DroneBotWorkshop/db1-robot-base/README.md

# db1-robot-base
 Base and drive section of DB1 Robot project

 Consists of following sub-sections:

 - Arduino Mega
 - Motor Controller
 - Corner Sensor
