DroneBotWorkshop/db1-robot-base/motor-controller/documentation/Motor-Control-2.0-REV-2-Schematic-2020-05-04.pdf

# Left Motor Controller

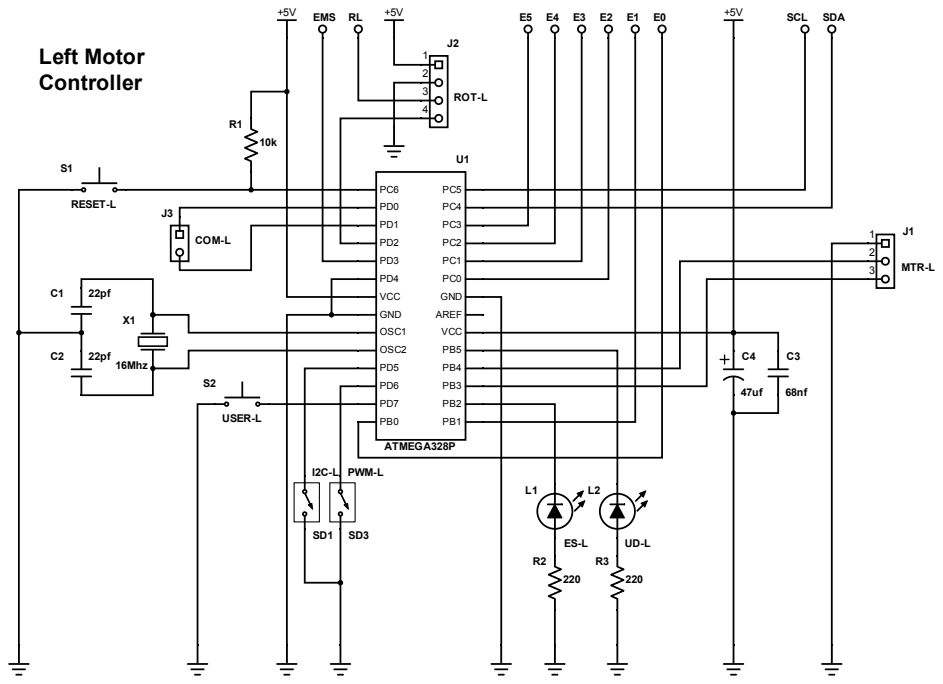
[picture p8: page 1]

# Right Motor Controller

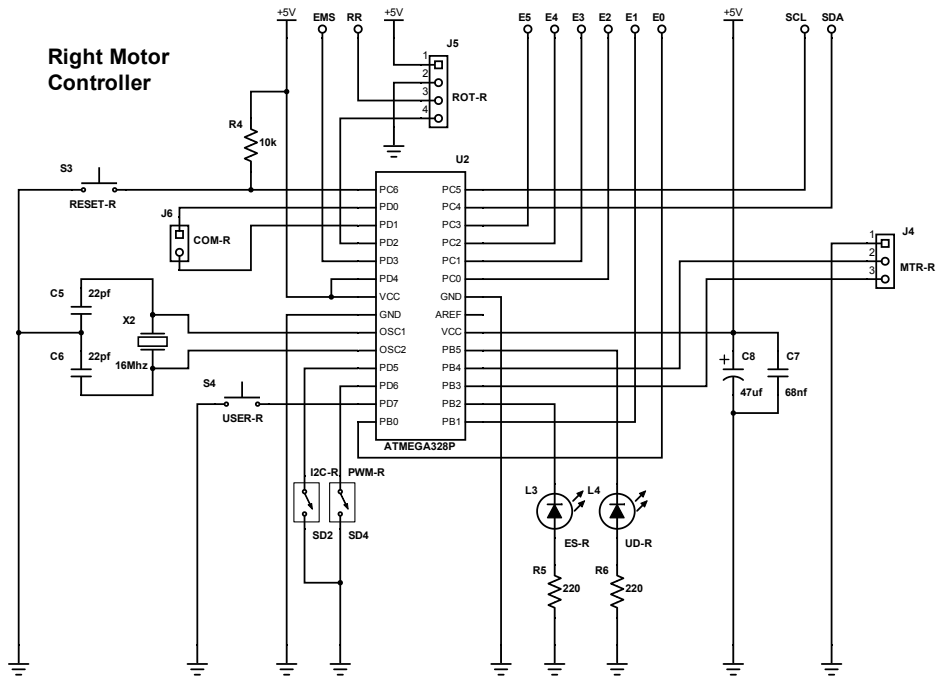
[picture p9: page 2]

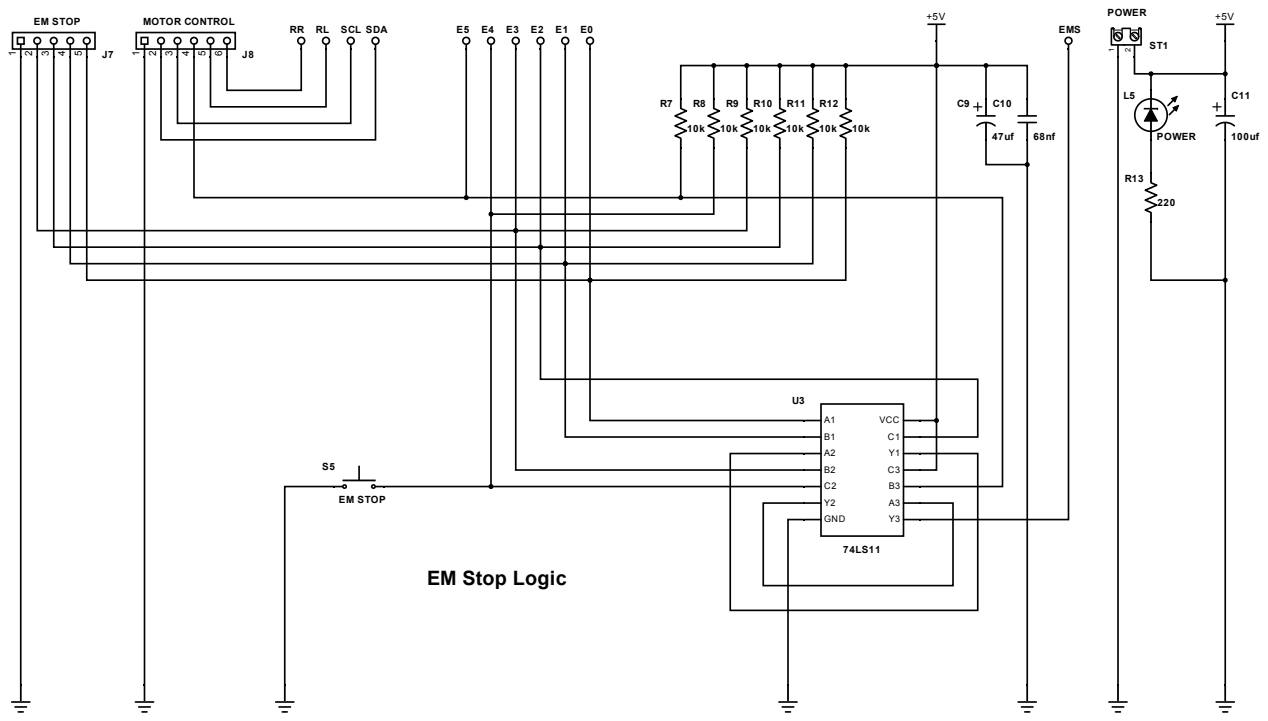
[picture p10: page 3]

RR RL SCL SDA
