DroneBotWorkshop/db1-robot-base/(commit log)

2020-04-26 Update db1-motor-control-movePWM.ino
    Original Motor Control Test Sketch
2020-04-26 Motor Control
2020-04-27 Motor Controller Test Code
    Experiments with motor controller. Code is not complete,
2020-04-29 Motor Controller Test
2020-04-29 Motor Controller Test with Em Stop
2020-04-30 Motor Controller Test Code
2020-04-30 DB1 Motor Test Code
2020-05-05 Motor Controller for DB1 Robot
2020-05-05 Motor Controller
